MinhNguy3n/simple-sequencer/Documentation/Schematic.PDF

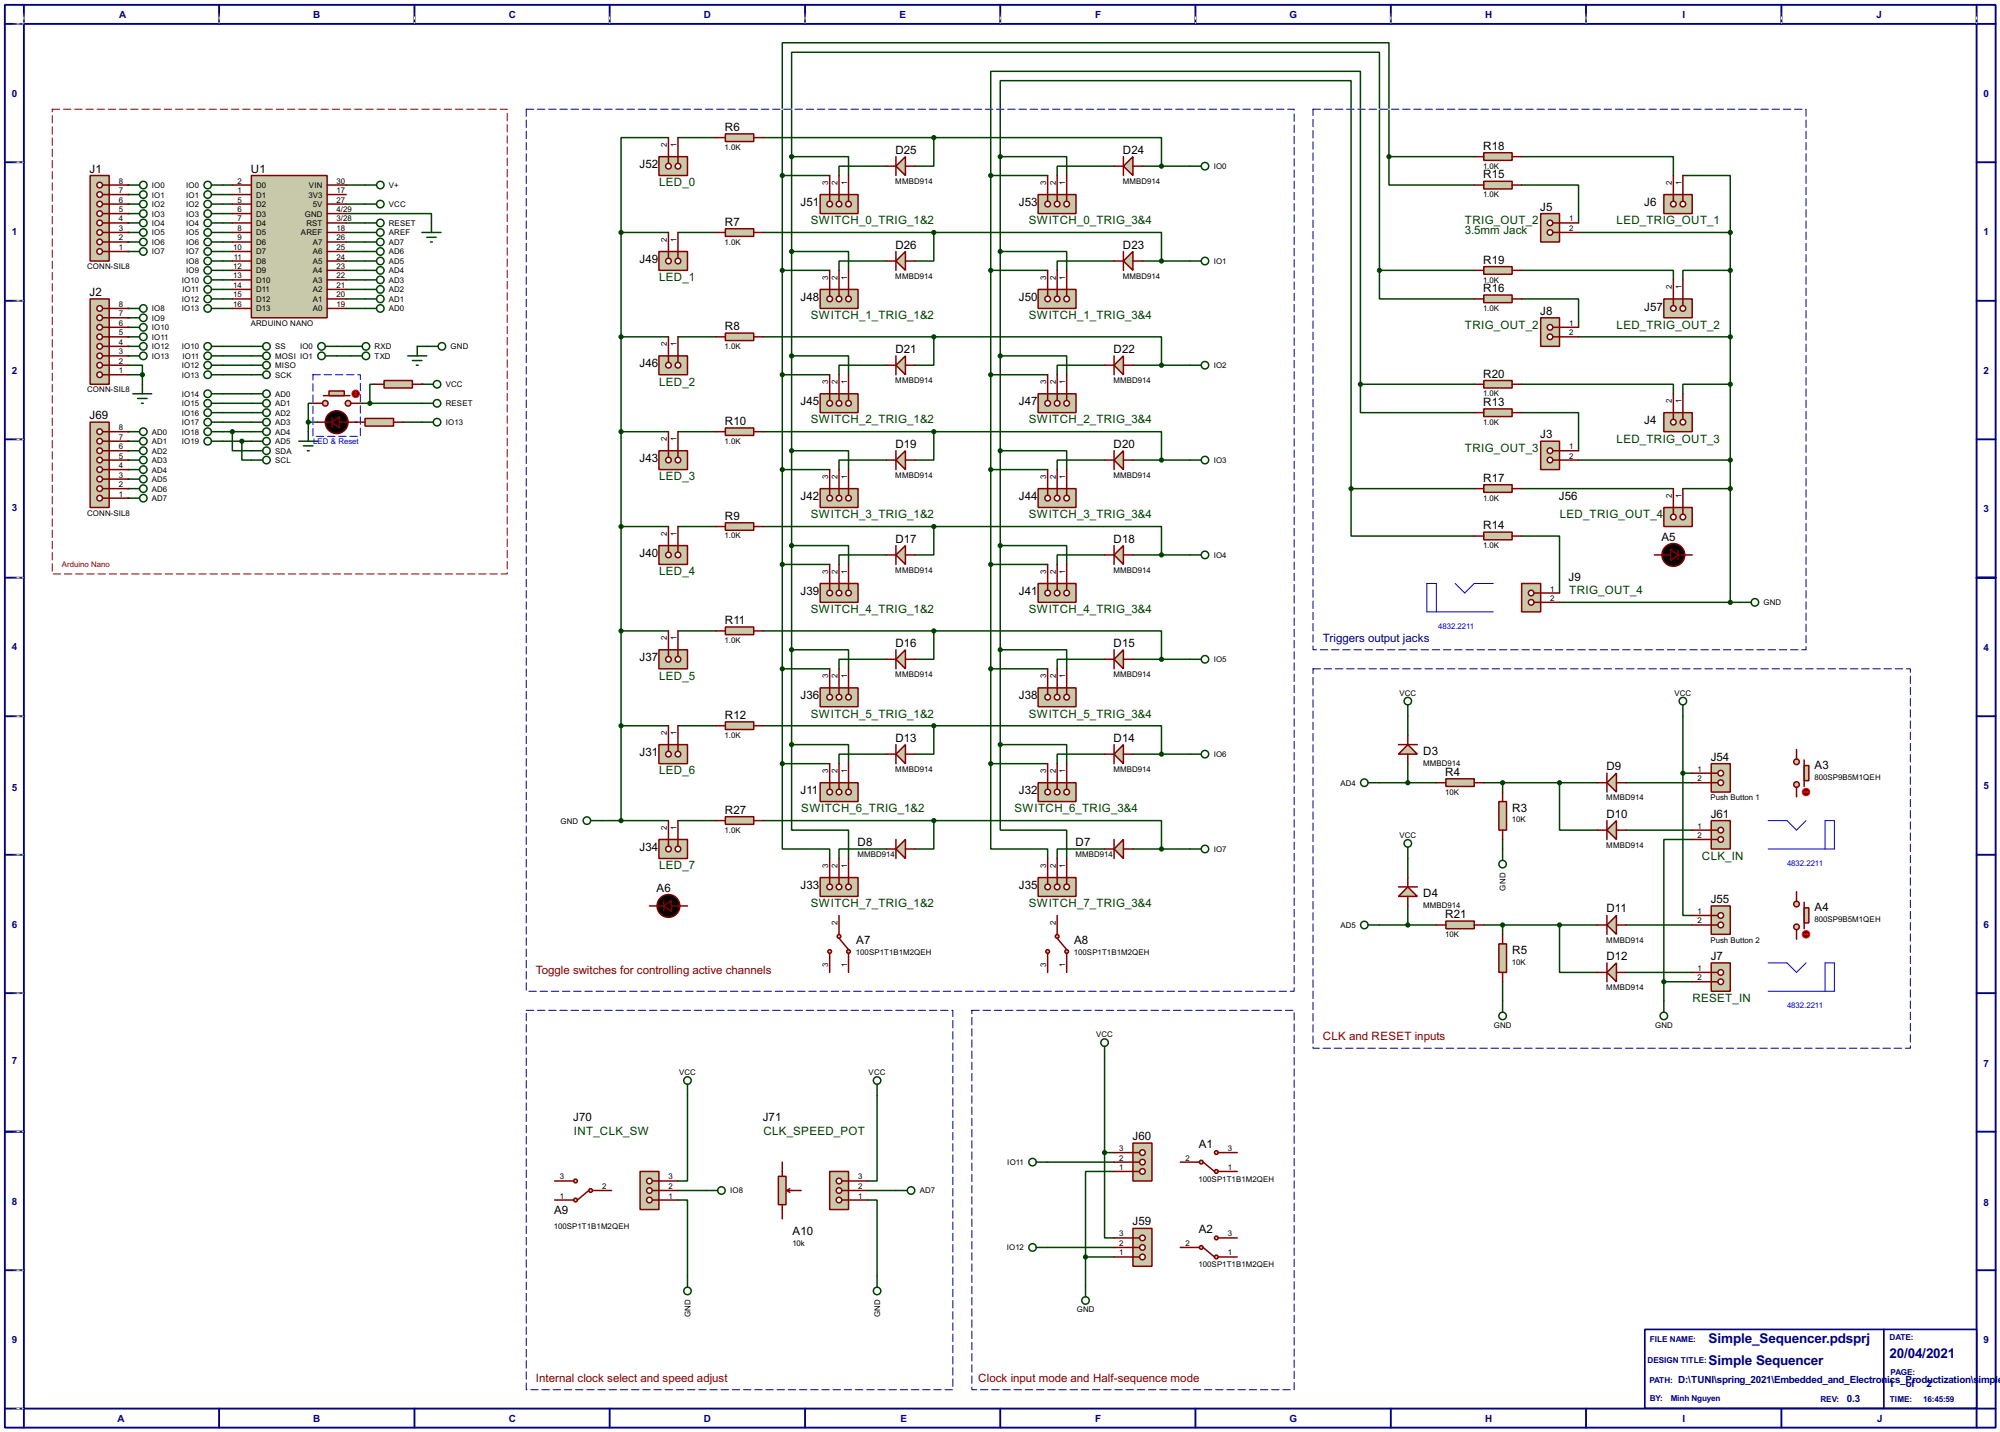
[picture p34: page 1]

GND Triggers output jacks

Toggle switches for controlling active channels

CLK and RESET inputs

DESIGN TITLE:Simple Sequencer

Internal clock select and speed adjust

Clock input mode and Half-sequence mode

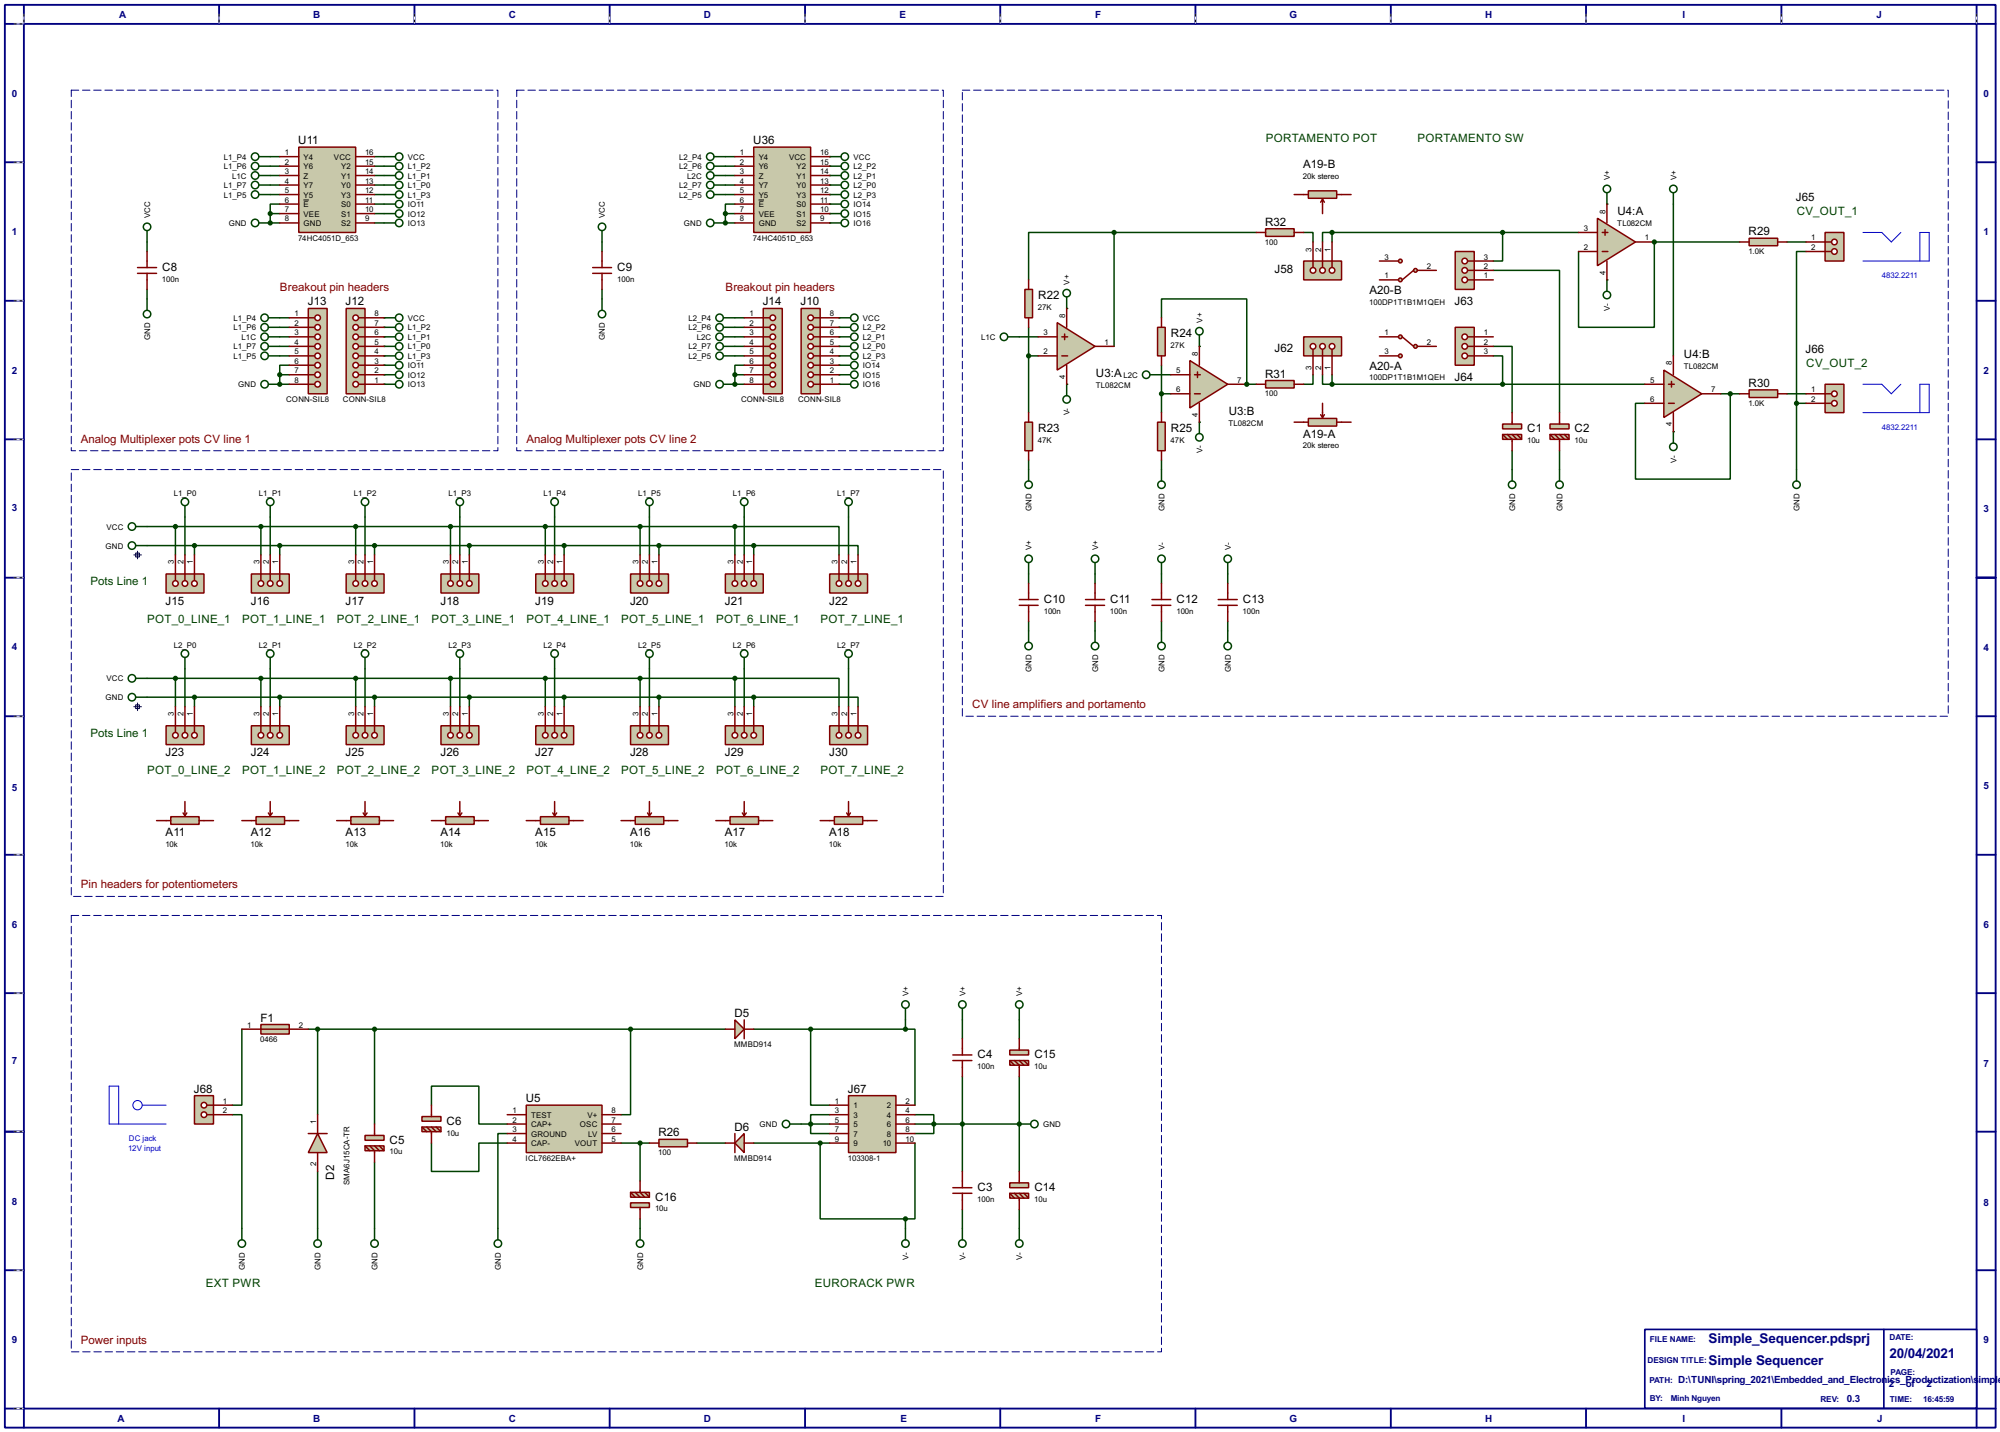
[picture p35: page 2]

Analog Multiplexer pots CV line 1

Analog Multiplexer pots CV line 2

CV line amplifiers and portamento

Pin headers for potentiometers

DESIGN TITLE:Simple Sequencer
