MinhNguy3n/simple-sequencer/Hardware/Simple_Sequencer.PDF

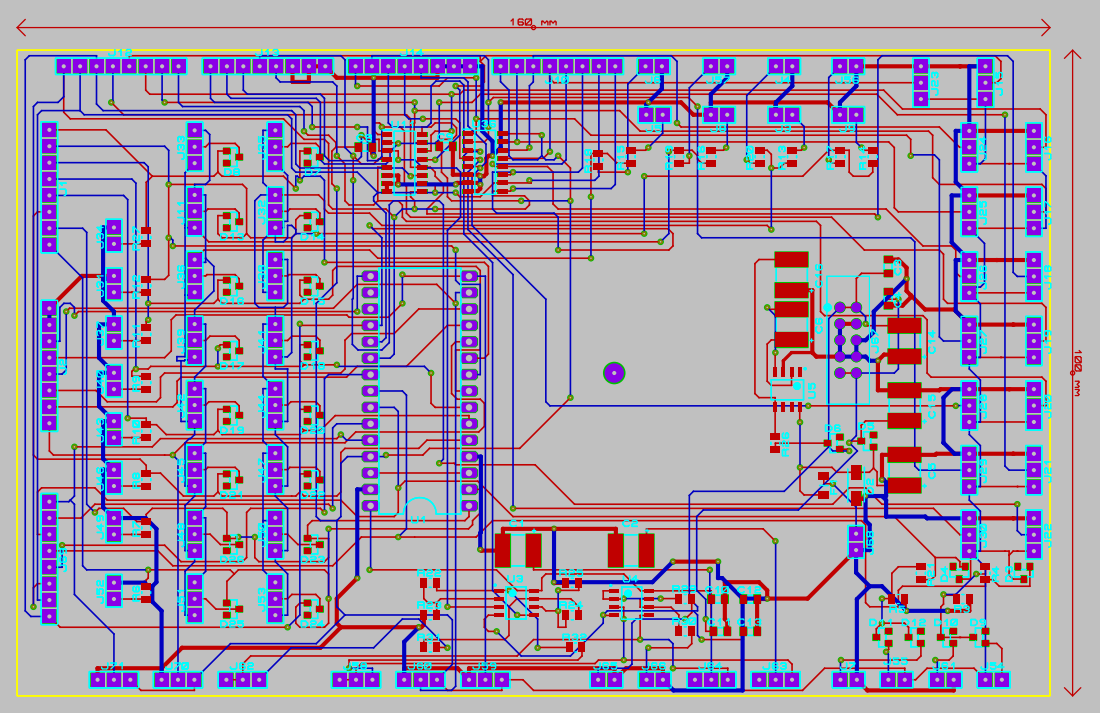
[picture p36: page 1]
