MinhNguy3n/simple-sequencer/Hardware/Simple_Sequencer__2_.PDF

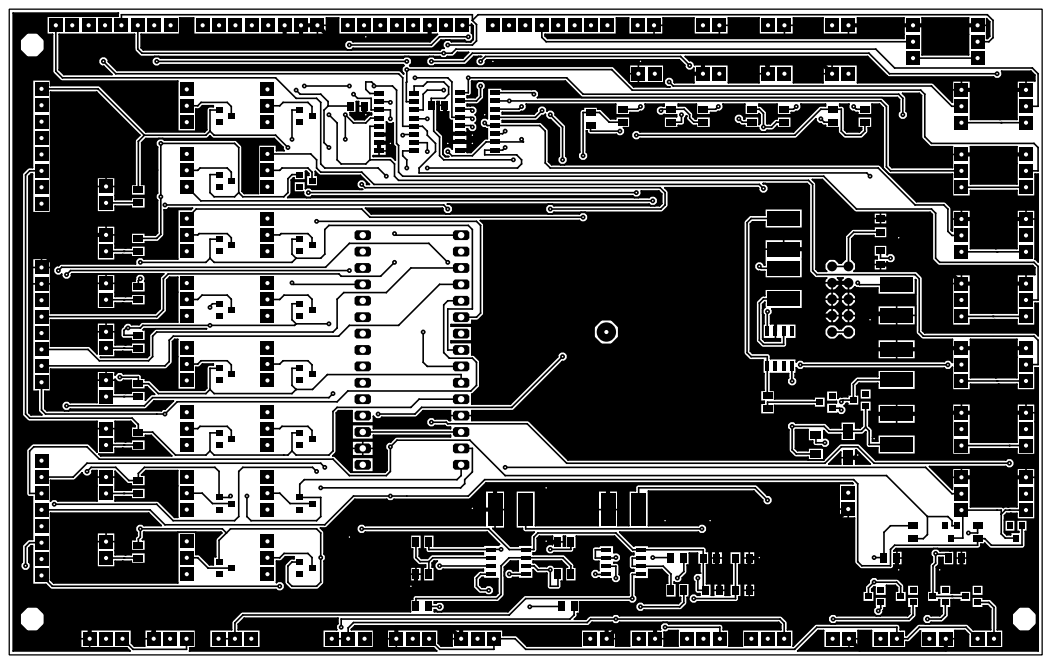
[picture p37: page 1]

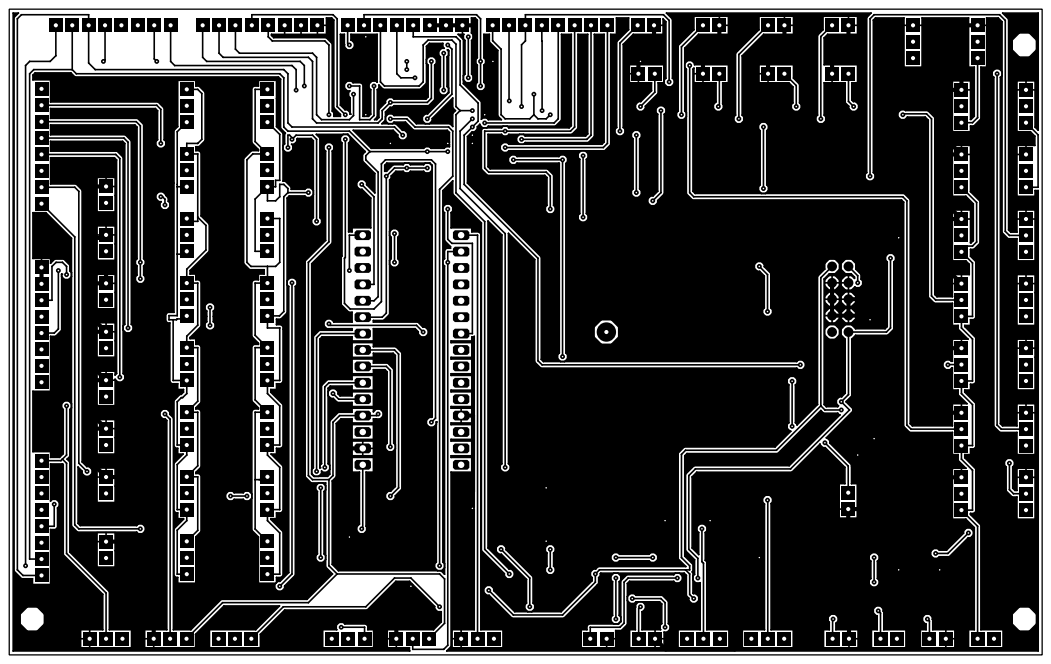
[picture p38: page 2]

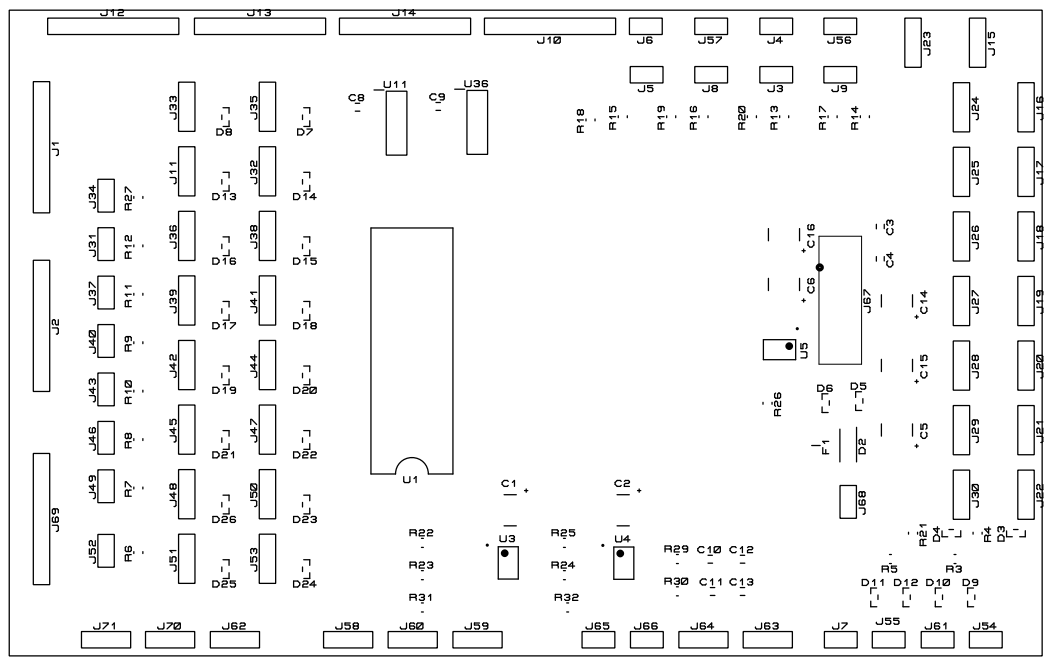
[picture p39: page 3]
