MinhNguy3n/simple-sequencer/Documentation/PCB layout.pdf

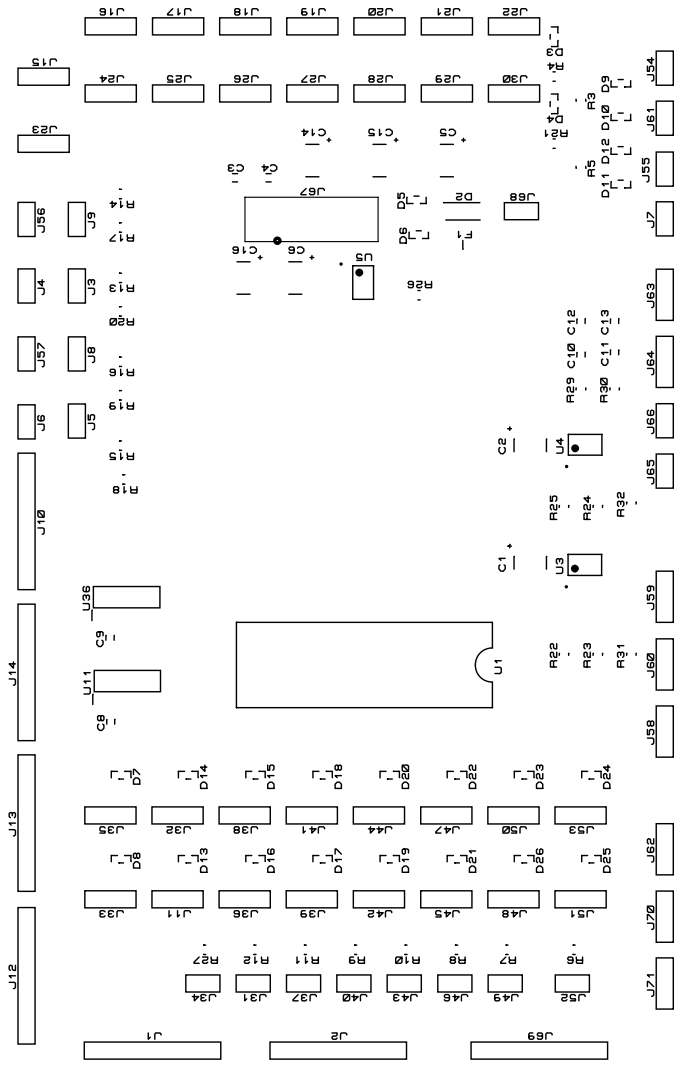
[picture p40: page 1]

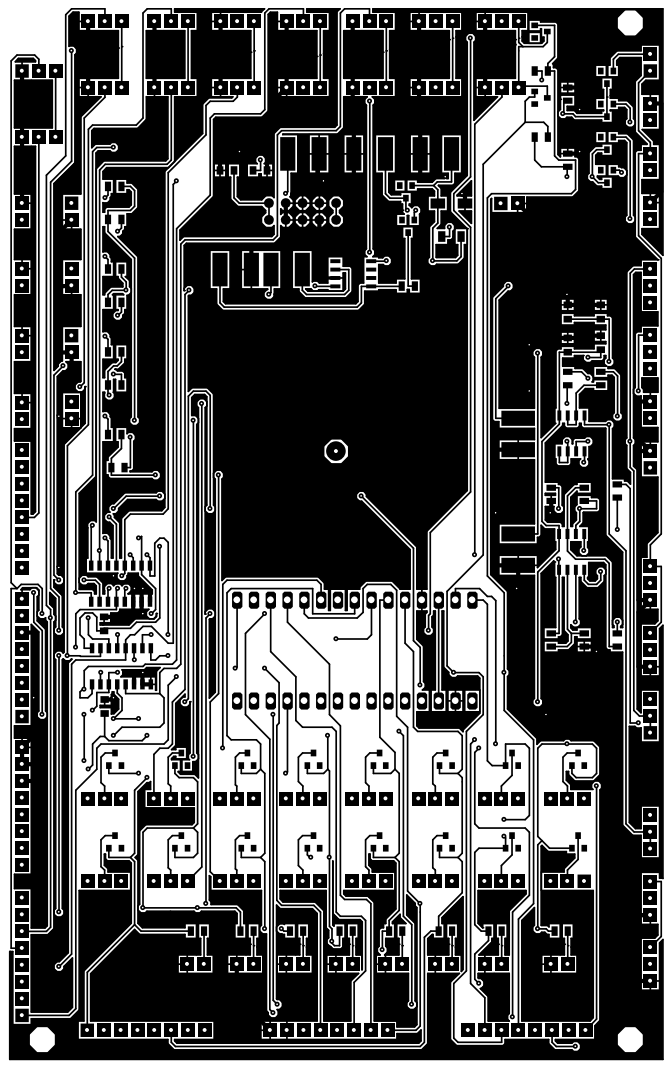
[picture p41: page 2]

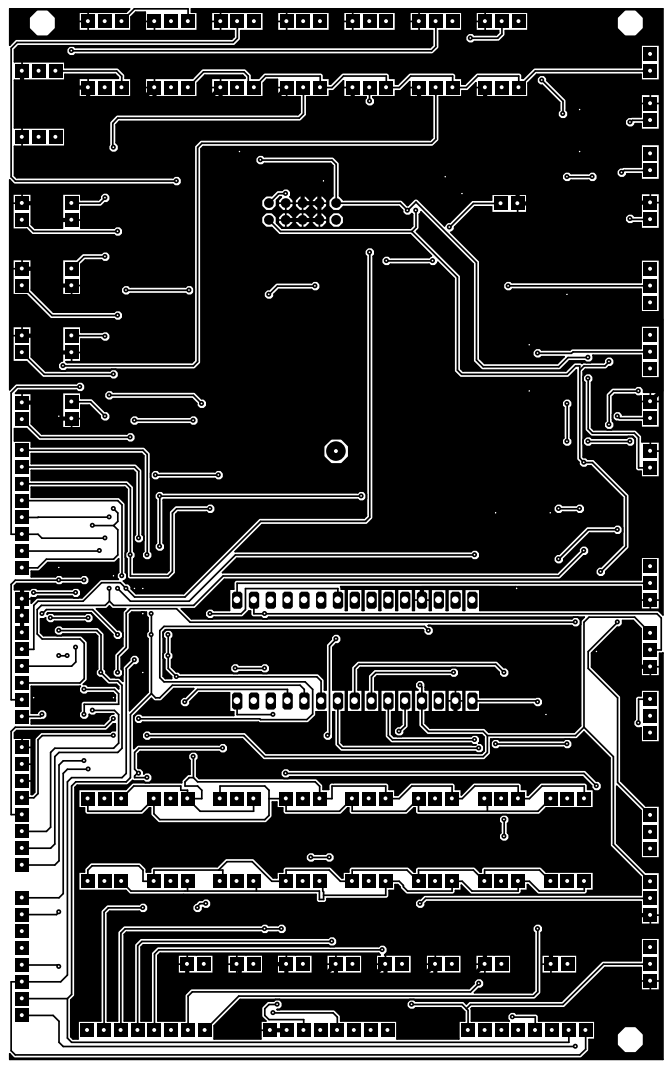
[picture p42: page 3]
