MinhNguy3n/simple-sequencer/(list of files, drawings)

Other design files:
Hardware/Simple Sequencer(Simulatable).pdsprj
Hardware/Simple_Sequencer.pdsprj
Hardware/Simple_Sequencer__2_.pdsprj
